go4retro/SuperPET_OS9_MMU/docs/assembly/u36_pin_desolder.jpg

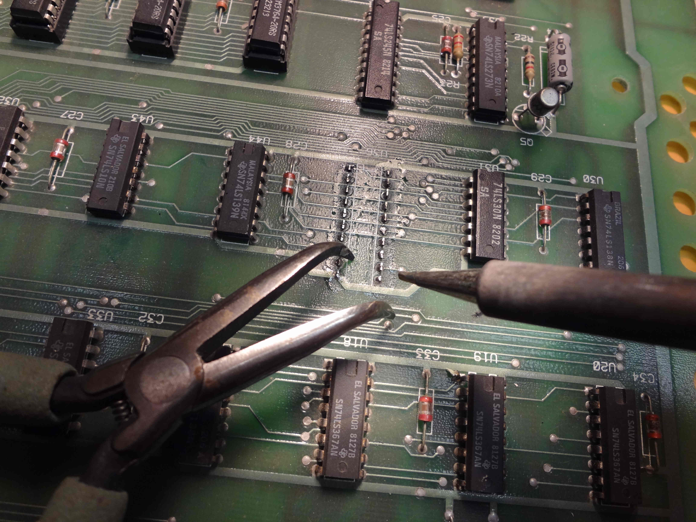
docs/assembly/u36_pin_desolder.jpg
