go4retro/SuperPET_OS9_MMU/README.md

# SuperPET_OS9_MMU
TPUG OS9 MMU Reproduction

 - [Information and Software](http://mikenaberezny.com/hardware/superpet/super-os9-mmu/)
 - [Purchase a Kit](http://store.go4retro.com/superpet-os-9-mmu/)
