go4retro/SuperPET_OS9_MMU/pcb/SuperPET OS9 MMU v2.9.brd

## EAGLE design pcb/SuperPET OS9 MMU v2.9.brd (2018-03-10)

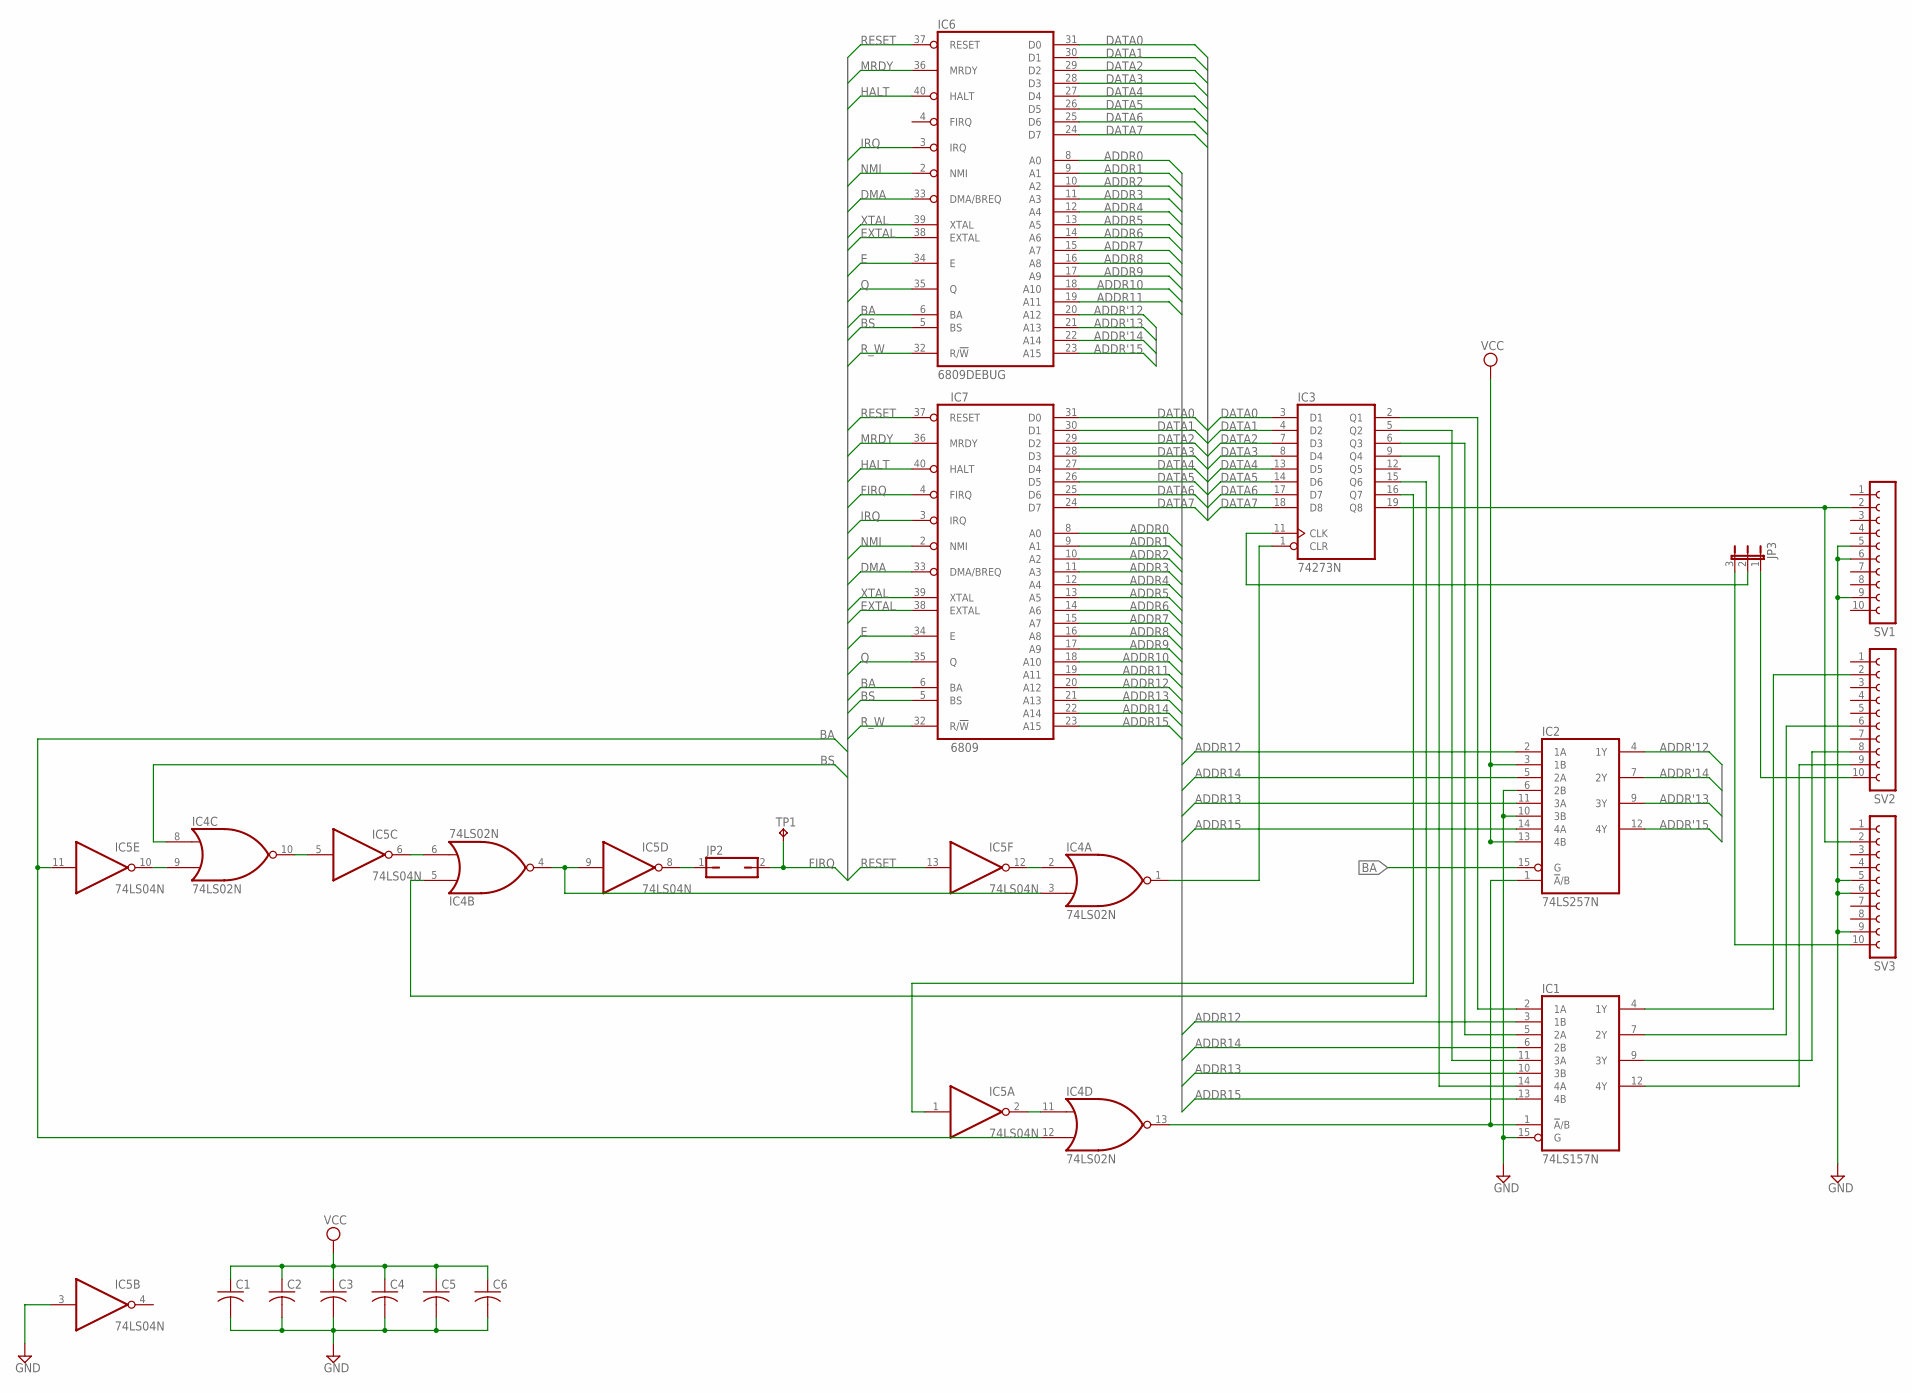
[picture p3: schematic SuperPET OS9 MMU v2.9.sch]

Parts:
C1, C2, C3, C4, C5, C6: C-US025-025X050; C025-025X050
IC1: 74LS157N; DIL16
IC2: 74LS257N; DIL16
IC3: 74273N; DIL20
IC4: 74LS02N; DIL14
IC5: 74LS04N; DIL14
IC6: 6809DEBUG; DIL40
IC7: 6809; DIL40
JP2: JP1Q; JP1
JP3: JP2E; JP2
SV1, SV2, SV3: FE10-1; FE10
TP1: TPPAD1-17; P1-17

Connections:
ADDR0: IC6.8 (A0), IC7.8 (A0)
ADDR1: IC6.9 (A1), IC7.9 (A1)
ADDR2: IC6.10 (A2), IC7.10 (A2)
ADDR3: IC6.11 (A3), IC7.11 (A3)
ADDR4: IC6.12 (A4), IC7.12 (A4)
ADDR5: IC6.13 (A5), IC7.13 (A5)
ADDR6: IC6.14 (A6), IC7.14 (A6)
ADDR7: IC6.15 (A7), IC7.15 (A7)
ADDR8: IC6.16 (A8), IC7.16 (A8)
ADDR9: IC6.17 (A9), IC7.17 (A9)
ADDR10: IC6.18 (A10), IC7.18 (A10)
ADDR11: IC6.19 (A11), IC7.19 (A11)
ADDR12: IC1.3 (1B), IC2.2 (1A), IC7.20 (A12)
ADDR13: IC1.10 (3B), IC2.11 (3A), IC7.21 (A13)
ADDR14: IC1.6 (2B), IC2.5 (2A), IC7.22 (A14)
ADDR15: IC1.13 (4B), IC2.14 (4A), IC7.23 (A15)
ADDR'12: IC2.4 (1Y), IC6.20 (A12)
ADDR'13: IC2.9 (3Y), IC6.21 (A13)
ADDR'14: IC2.7 (2Y), IC6.22 (A14)
ADDR'15: IC2.12 (4Y), IC6.23 (A15)
BA: IC2.15 (G), IC4.12 (I1), IC5.11 (I), IC6.6 (BA), IC7.6 (BA)
BS: IC4.8 (I0), IC6.5 (BS), IC7.5 (BS)
DATA0: IC3.3 (D1), IC6.31 (D0), IC7.31 (D0)
DATA1: IC3.4 (D2), IC6.30 (D1), IC7.30 (D1)
DATA2: IC3.7 (D3), IC6.29 (D2), IC7.29 (D2)
DATA3: IC3.8 (D4), IC6.28 (D3), IC7.28 (D3)
DATA4: IC3.13 (D5), IC6.27 (D4), IC7.27 (D4)
DATA5: IC3.14 (D6), IC6.26 (D5), IC7.26 (D5)
DATA6: IC3.17 (D7), IC6.25 (D6), IC7.25 (D6)
DATA7: IC3.18 (D8), IC6.24 (D7), IC7.24 (D7)
DMA: IC6.33 (DMA/BREQ), IC7.33 (DMA/BREQ)
E: IC6.34 (E), IC7.34 (E)
EXTAL: IC6.38 (EXTAL), IC7.38 (EXTAL)
FIRQ: IC7.4 (FIRQ), JP2.2, TP1.1
GND: C1.2, C2.2, C3.2, C4.2, C5.2, C6.2, IC1.8 (GND), IC1.15 (G), IC2.6 (2B), IC2.8 (GND), IC2.10 (3B), IC3.10 (GND), IC4.7 (GND), IC5.3 (I), IC5.7 (GND), IC6.1 (GND), IC7.1 (GND), SV1.5, SV1.6, SV1.9, SV3.5, SV3.6, SV3.9
HALT: IC6.40 (HALT), IC7.40 (HALT)
IRQ: IC6.3 (IRQ), IC7.3 (IRQ)
MRDY: IC6.36 (MRDY), IC7.36 (MRDY)
unnamed: IC1.1 (!A!/B), IC2.1 (!A!/B), IC4.13 (O)
unnamed: IC3.1 (CLR), IC4.1 (O)
unnamed: IC4.2 (I0), IC5.12 (O)
unnamed: IC5.8 (O), JP2.1
unnamed: IC4.3 (I1), IC4.4 (O), IC5.9 (I)
unnamed: IC3.15 (Q6), IC4.5 (I0)
unnamed: IC4.6 (I1), IC5.6 (O)
unnamed: IC4.10 (O), IC5.5 (I)
unnamed: IC4.9 (I1), IC5.10 (O)
unnamed: IC4.11 (I0), IC5.2 (O)
unnamed: IC3.16 (Q7), IC5.1 (I)
unnamed: IC1.2 (1A), IC3.2 (Q1)
unnamed: IC1.14 (4A), IC3.9 (Q4)
unnamed: IC1.11 (3A), IC3.5 (Q2)
unnamed: IC1.7 (2Y), SV2.6
unnamed: IC3.19 (Q8), SV1.2, SV3.2
unnamed: IC1.12 (4Y), SV2.9
unnamed: JP3.1, SV2.10
unnamed: IC3.11 (CLK), JP3.2
unnamed: JP3.3, SV3.10
unnamed: IC1.5 (2A), IC3.6 (Q3)
unnamed: IC1.4 (1Y), SV2.2
unnamed: IC1.9 (3Y), SV2.8
NMI: IC6.2 (NMI), IC7.2 (NMI)
Q: IC6.35 (Q), IC7.35 (Q)
RESET: IC5.13 (I), IC6.37 (RESET), IC7.37 (RESET)
R_W: IC6.32 (R/!W), IC7.32 (R/!W)
VCC: C1.1, C2.1, C3.1, C4.1, C5.1, C6.1, IC1.16 (VCC), IC2.3 (1B), IC2.13 (4B), IC2.16 (VCC), IC3.20 (VCC), IC4.14 (VCC), IC5.14 (VCC), IC6.7 (VCC), IC7.7 (VCC)
XTAL: IC6.39 (XTAL), IC7.39 (XTAL)

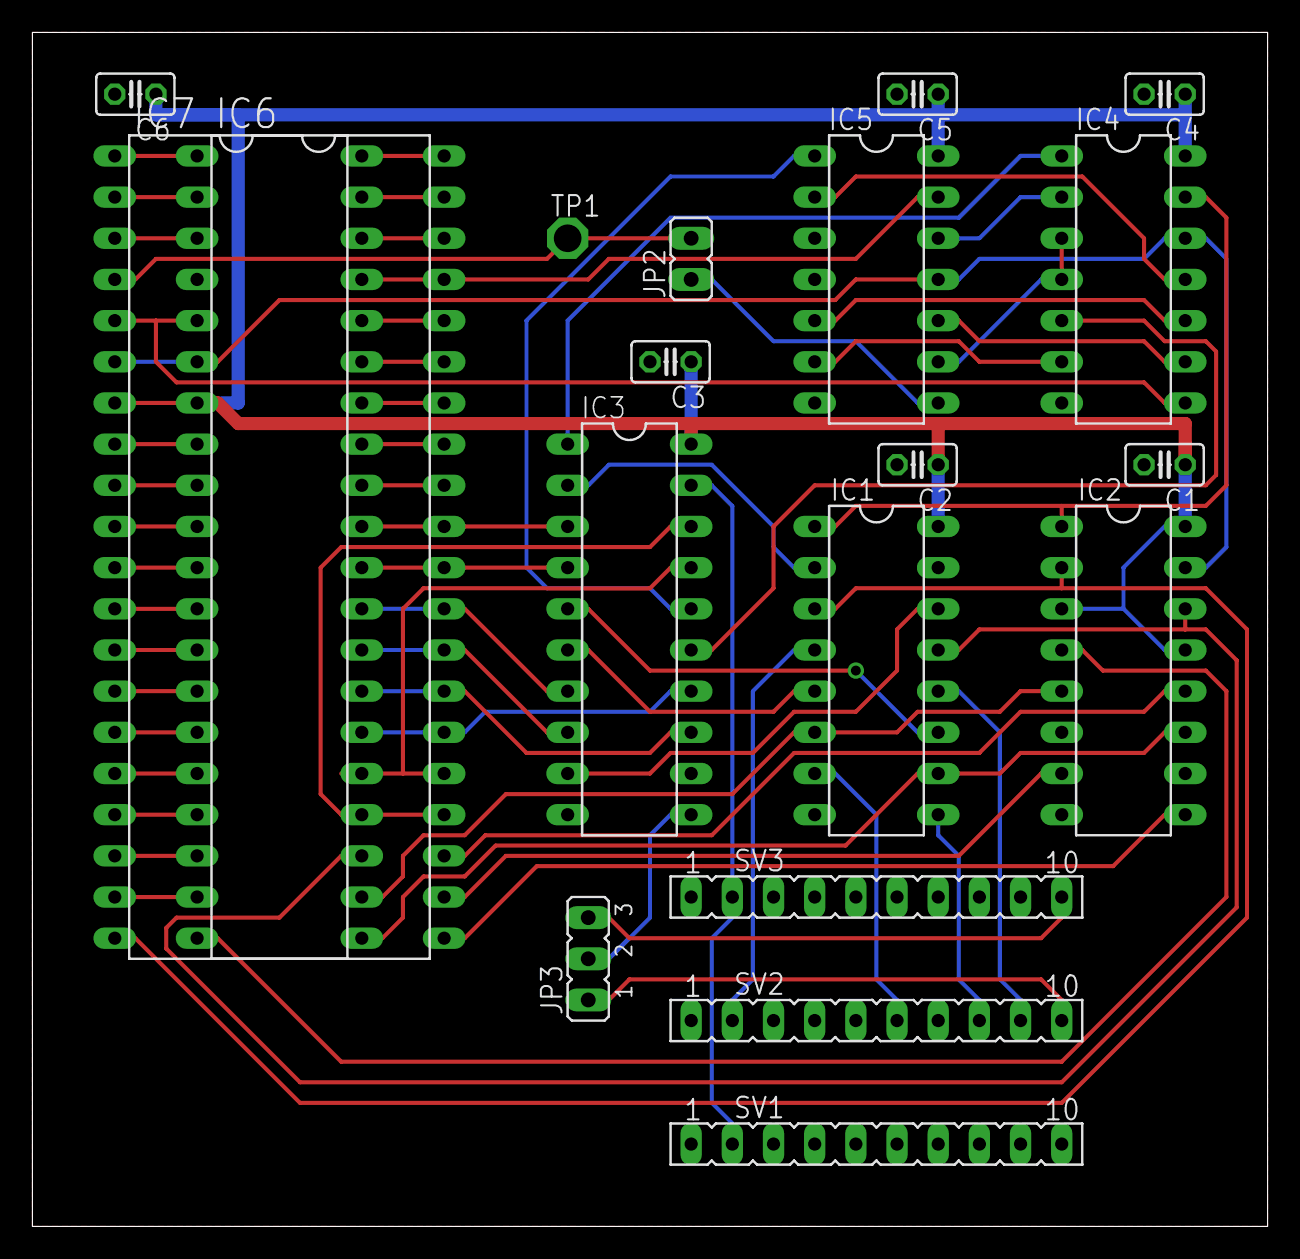
[picture p4: board SuperPET OS9 MMU v2.9.brd from above]

Board: 2 copper layers, 76.2 x 73.7 mm, 19 parts (0 on the bottom side), 67 nets.
