go4retro/SuperPET_OS9_MMU/docs/assembly/ab_align.jpg

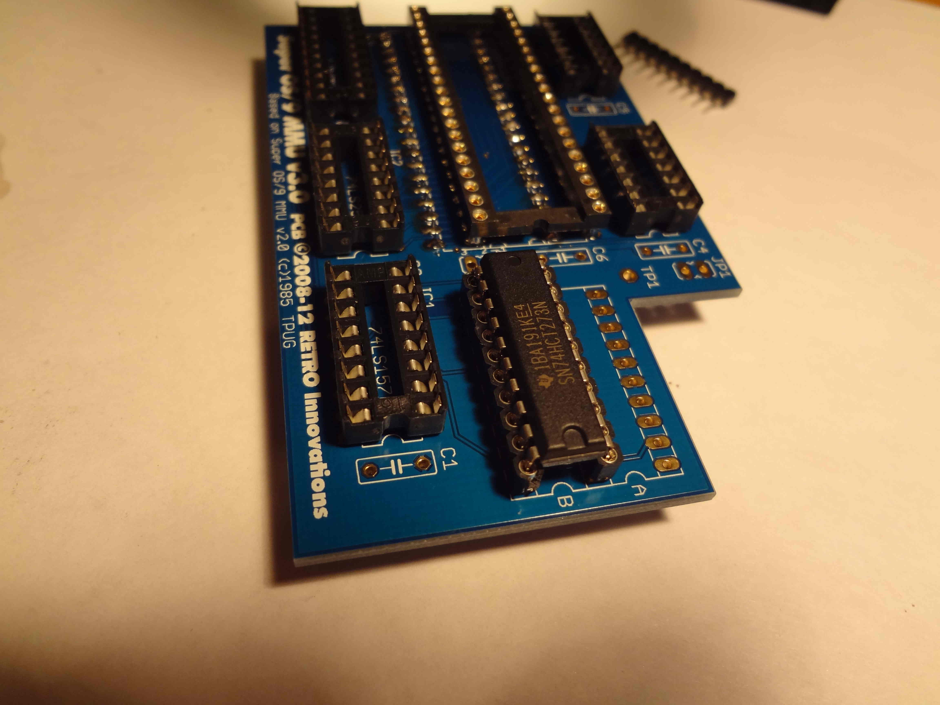
docs/assembly/ab_align.jpg
