go4retro/SuperPET_OS9_MMU/docs/assembly/ab_done.jpg

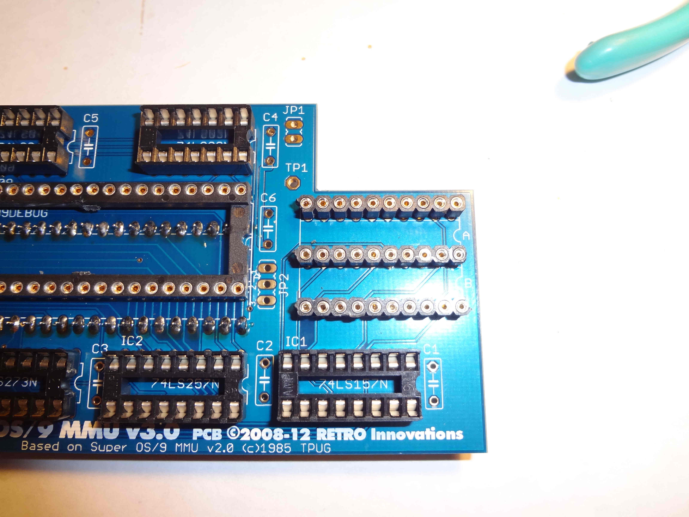
docs/assembly/ab_done.jpg
