go4retro/SuperPET_OS9_MMU/docs/assembly/caps_jumpers.jpg

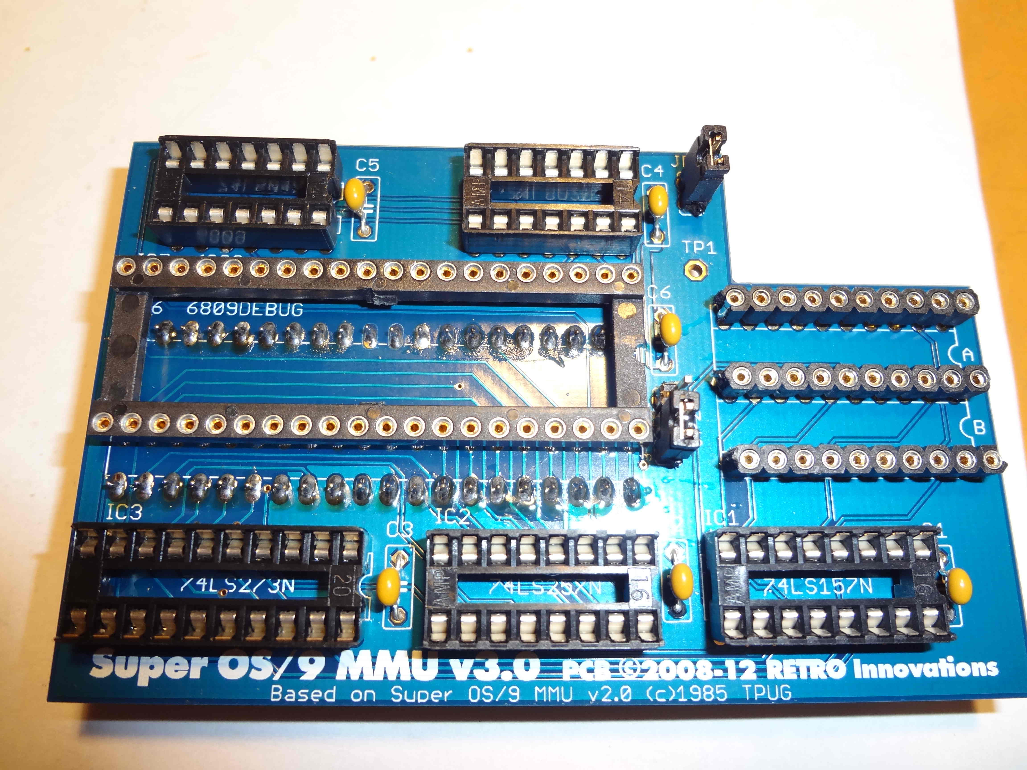
docs/assembly/caps_jumpers.jpg
