go4retro/SuperPET_OS9_MMU/docs/assembly/chips_inserted.jpg

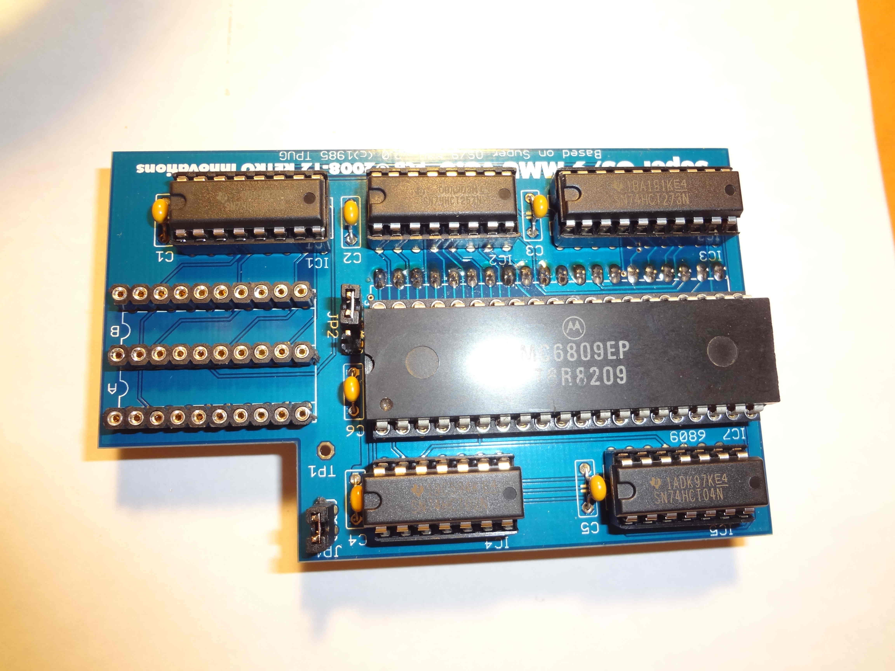
docs/assembly/chips_inserted.jpg
