go4retro/SuperPET_OS9_MMU/docs/assembly/cpu_header_orient.jpg

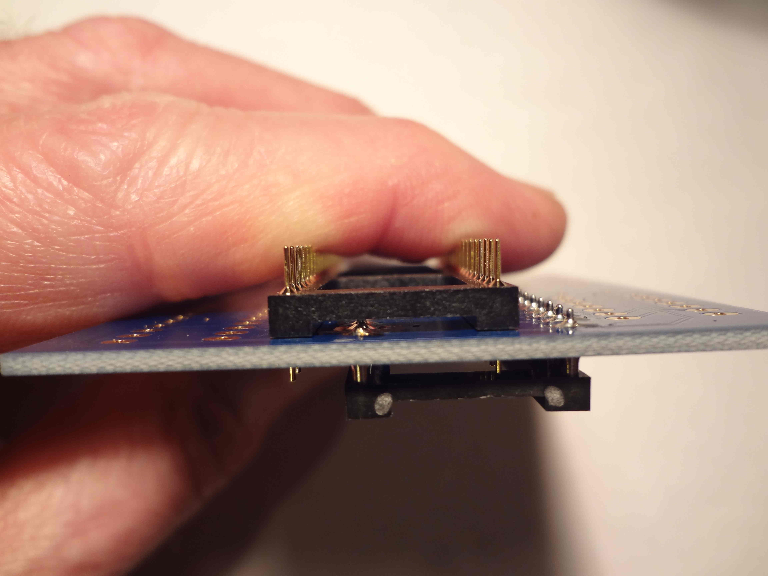
docs/assembly/cpu_header_orient.jpg
