go4retro/SuperPET_OS9_MMU/docs/assembly/cpu_socket_bot.jpg

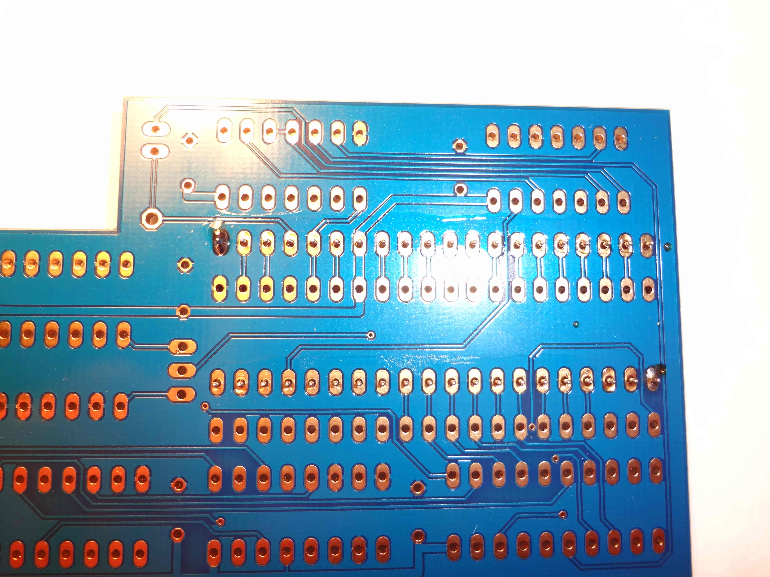
docs/assembly/cpu_socket_bot.jpg
