go4retro/SuperPET_OS9_MMU/docs/assembly/cpu_socket_top.jpg

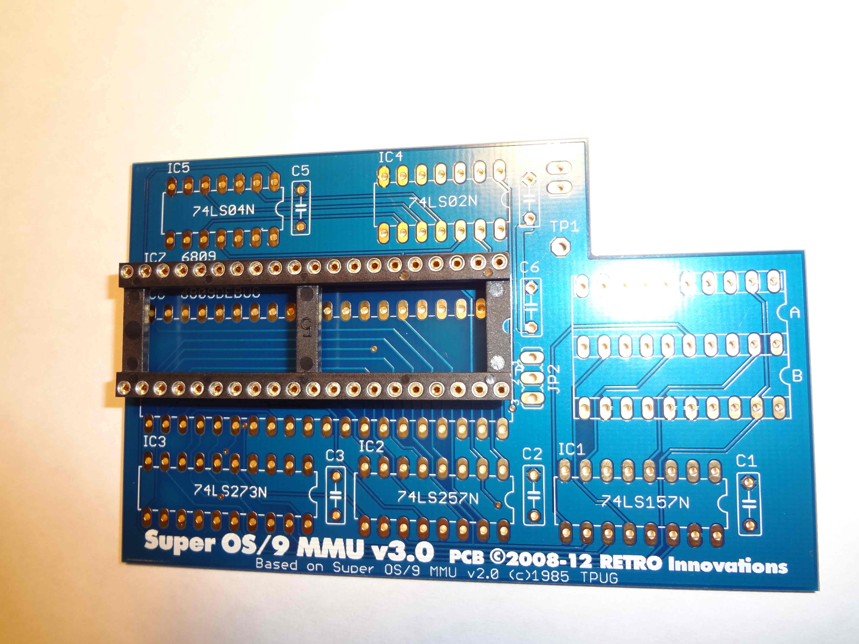
docs/assembly/cpu_socket_top.jpg
