go4retro/SuperPET_OS9_MMU/docs/assembly/disassemble.jpg

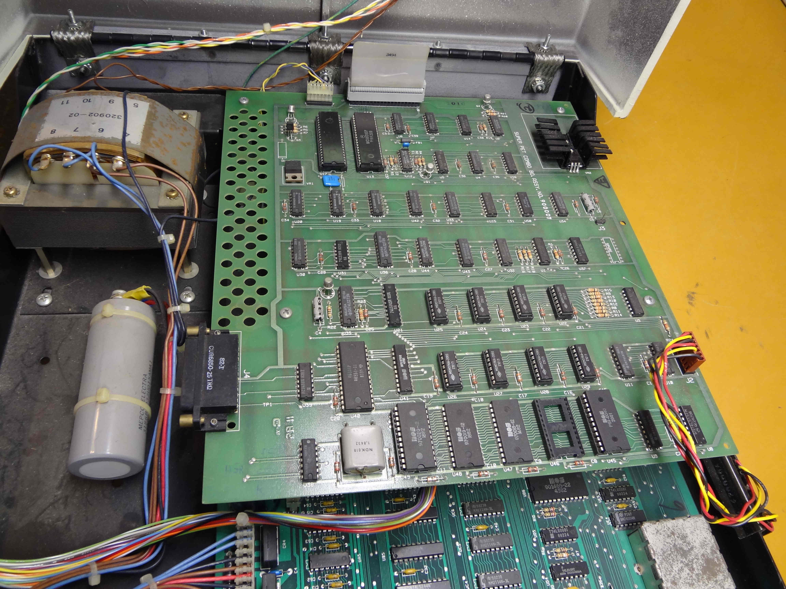
docs/assembly/disassemble.jpg
