go4retro/SuperPET_OS9_MMU/docs/assembly/header_ext.jpg

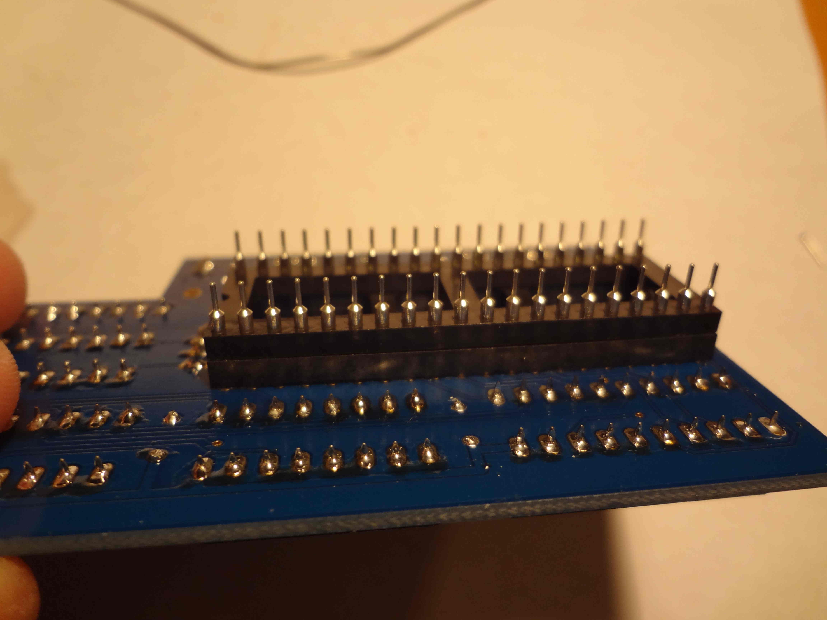
docs/assembly/header_ext.jpg
