go4retro/SuperPET_OS9_MMU/docs/assembly/pull_6809.jpg

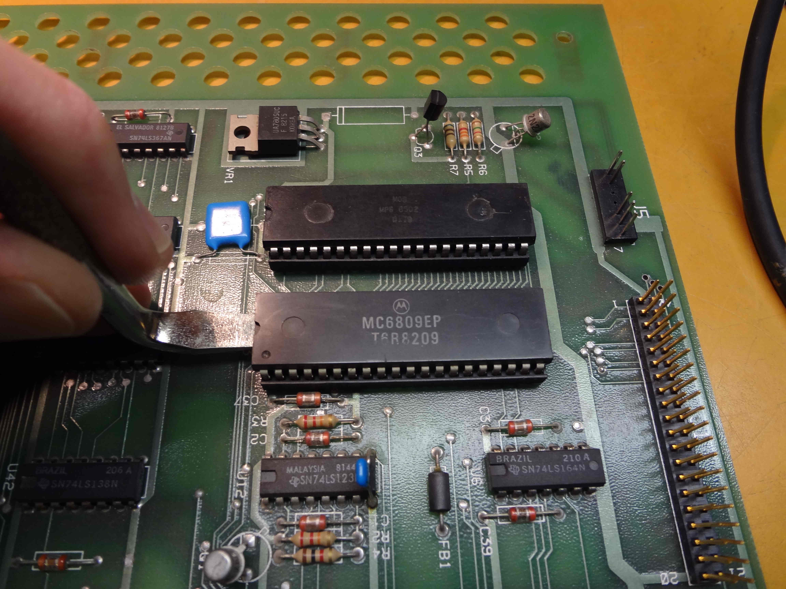
docs/assembly/pull_6809.jpg
