go4retro/SuperPET_OS9_MMU/docs/assembly/reassembled.jpg

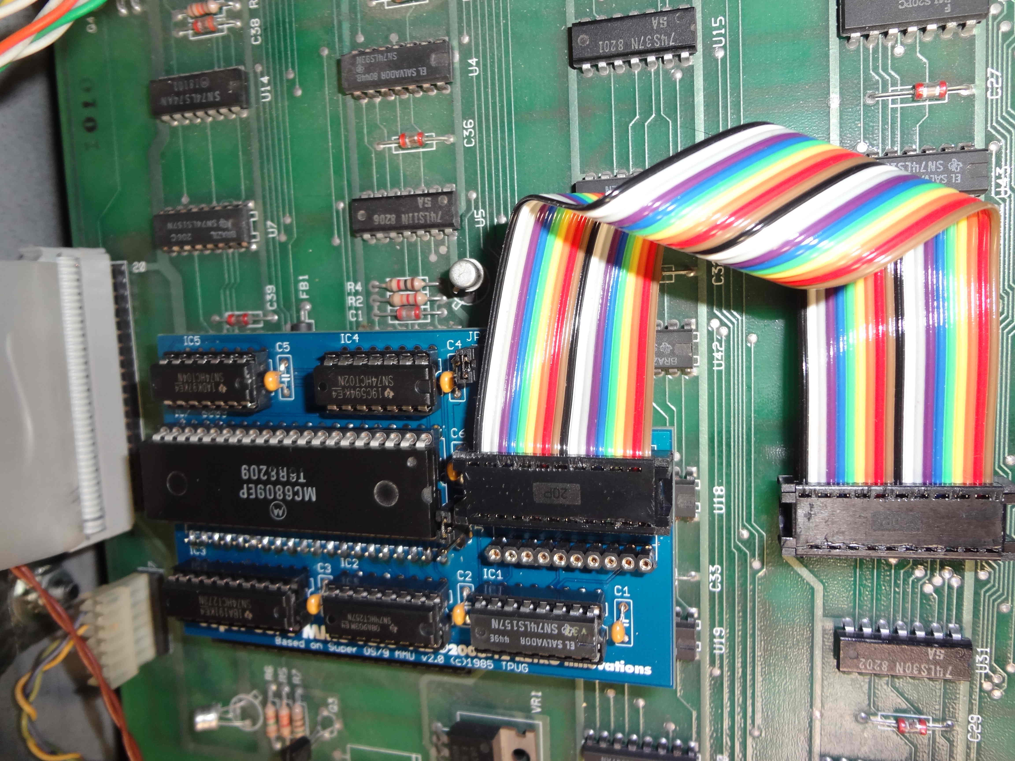
docs/assembly/reassembled.jpg
