go4retro/SuperPET_OS9_MMU/docs/assembly/u36_cleaned.jpg

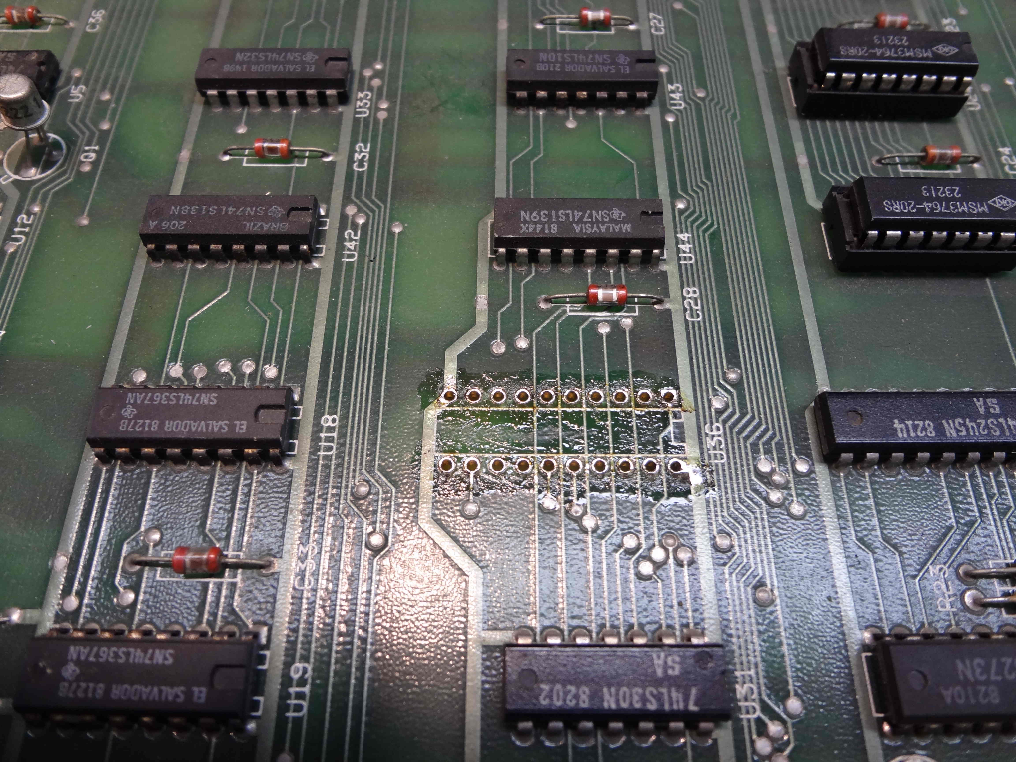
docs/assembly/u36_cleaned.jpg
