go4retro/SuperPET_OS9_MMU/docs/assembly/u36_clipped.jpg

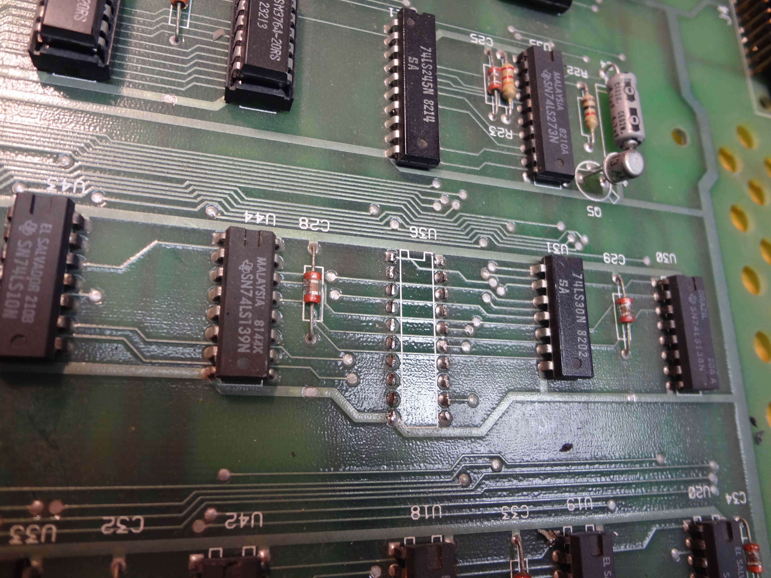
docs/assembly/u36_clipped.jpg
