go4retro/SuperPET_OS9_MMU/docs/assembly/u36_remove.jpg

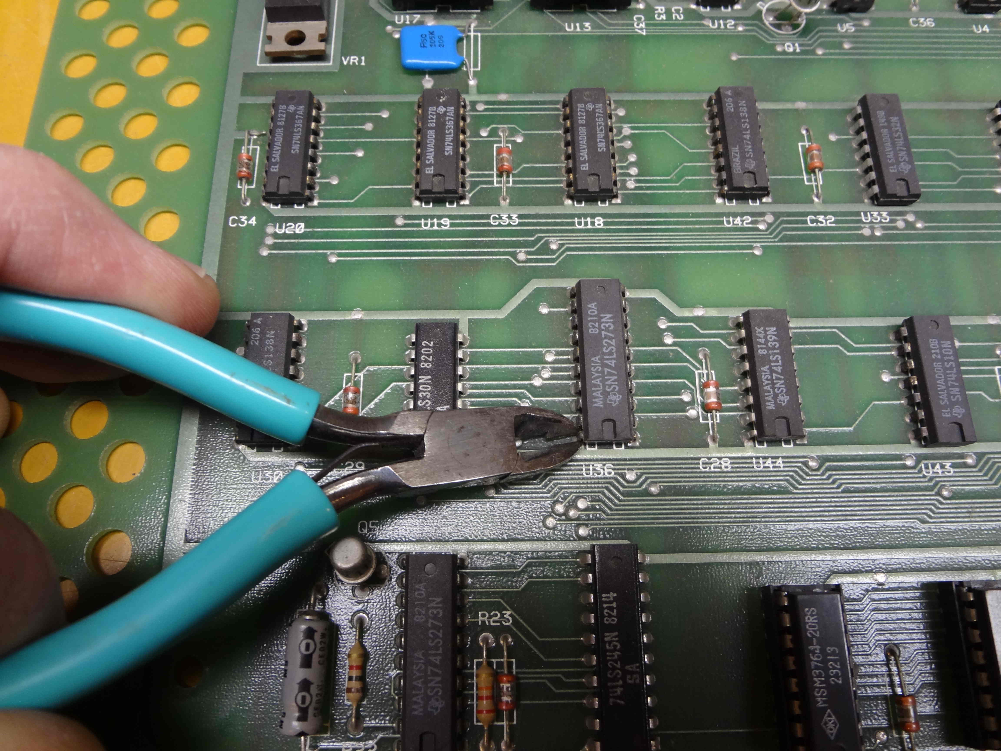
docs/assembly/u36_remove.jpg
