go4retro/SuperPET_OS9_MMU/docs/assembly/u36_socket.jpg

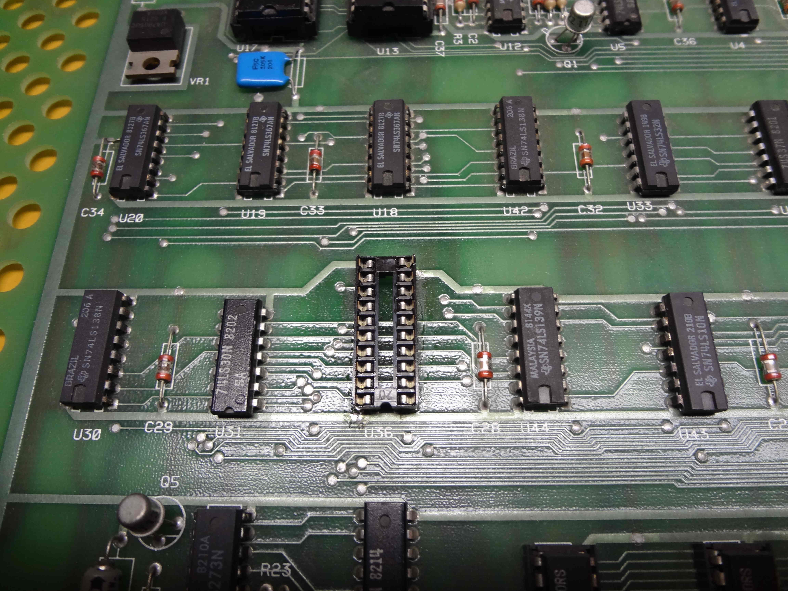
docs/assembly/u36_socket.jpg
