go4retro/SuperPET_OS9_MMU/(notices)

Notices in the files:
pcb/SuperPET OS9 MMU 3.0.brd:
Based on Super OS/9 MMU v2.0 (c)1985 TPUG
